phorton1/Arduino-boat-teensyGPS/docs/3dp/gps_test_nut1.3mf

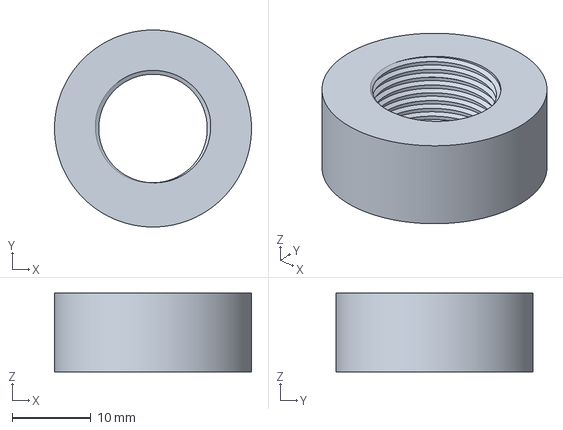
[picture p1: CAD file, 2026-04-03]
docs/3dp/gps_test_nut1.3mf
25.0 x 25.0 x 10.0 mm
