phorton1/Arduino-boat-teensyGPS/docs/3dp/gps_test_nut2.3mf

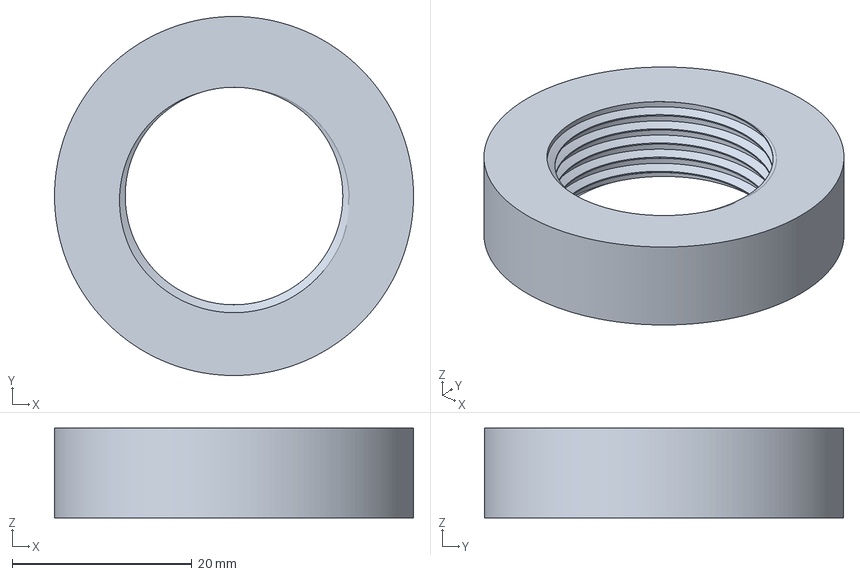
[picture p2: CAD file, 2026-04-03]
docs/3dp/gps_test_nut2.3mf
40.0 x 40.0 x 10.0 mm
