phorton1/Arduino-boat-teensyGPS/docs/3dp/gps_mount.3mf

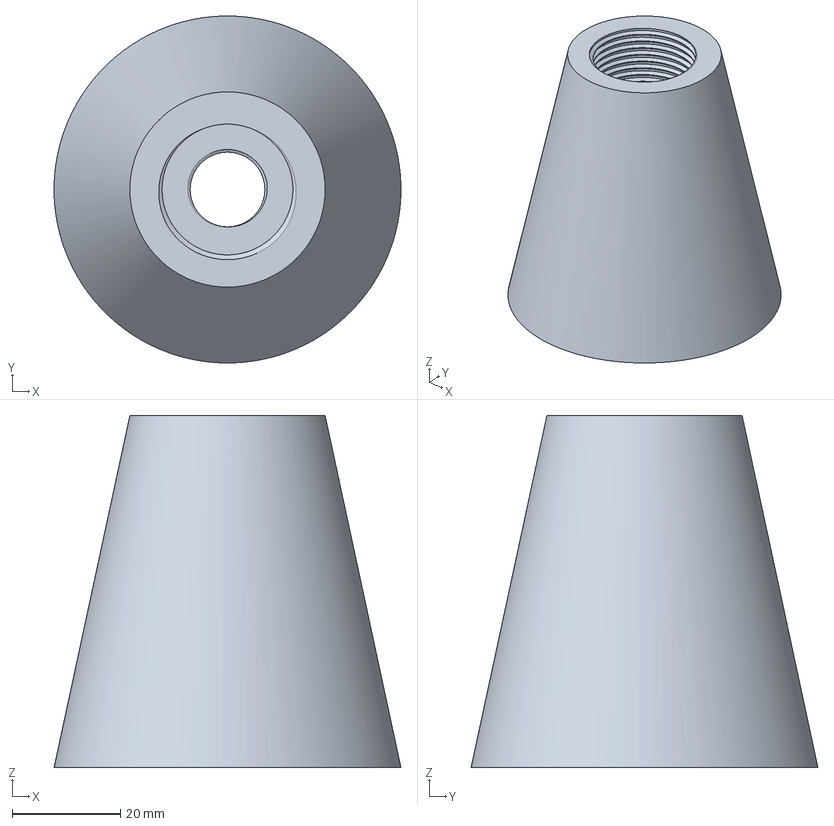
[picture p3: CAD file, 2026-04-03]
docs/3dp/gps_mount.3mf
64.0 x 64.0 x 65.0 mm
