phorton1/Arduino-boat-teensyGPS/docs/3dp/neo_support.3mf

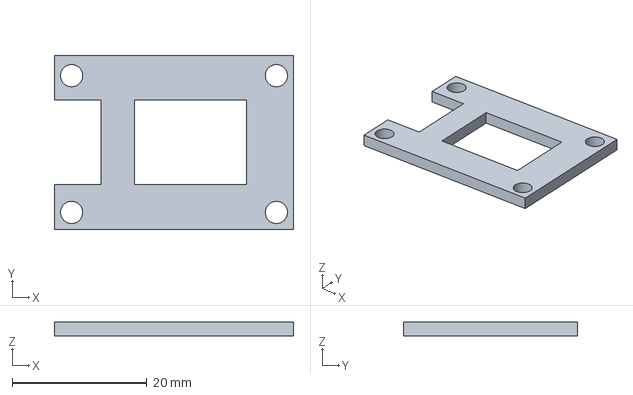
[picture p4: CAD file, 2026-02-25]
docs/3dp/neo_support.3mf
35.5 x 25.8 x 2.10 mm
