phorton1/Arduino-boat-teensyGPS/docs/3dp/gps_case.3mf

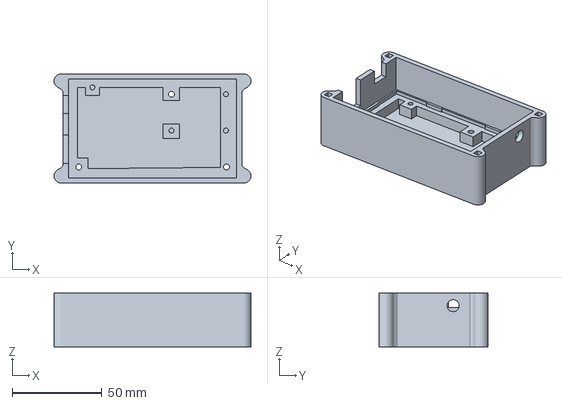
[picture p5: CAD file, 2026-02-25]
docs/3dp/gps_case.3mf
110.0 x 61.0 x 30.0 mm
