phorton1/Arduino-boat-teensyGPS/docs/3dp/gps_top.3mf

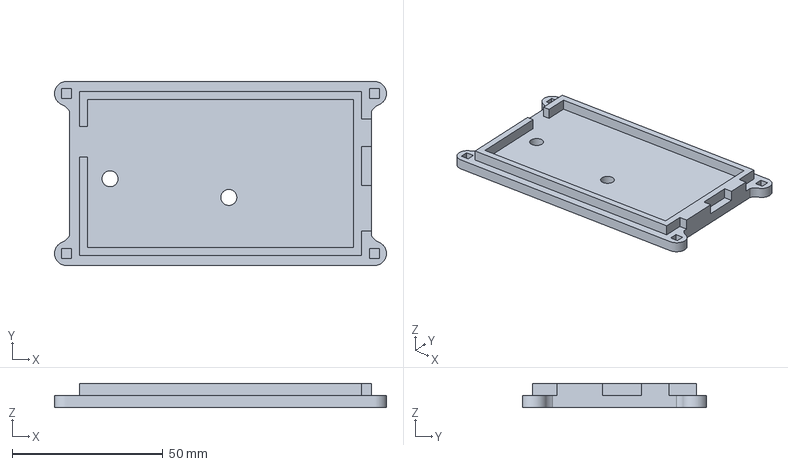
[picture p6: CAD file, 2026-02-25]
docs/3dp/gps_top.3mf
110.0 x 61.0 x 8.00 mm
