phorton1/Arduino-boat-teensyGPS/(list of files, cad)

Other CAD files:
docs/3dp/gps_box.f3d
docs/3dp/gps_case.stl
docs/3dp/gps_mount.stl
docs/3dp/gps_test_nut1.stl
docs/3dp/gps_test_nut2.stl
docs/3dp/gps_top.stl
docs/3dp/neo_support.stl
