phorton1/Arduino-boat-teensyGPS/docs/kicad/gps_board/gps_board.kicad_pcb

## KiCad design docs/kicad/gps_board/gps_board.kicad_pcb (2026-02-25)

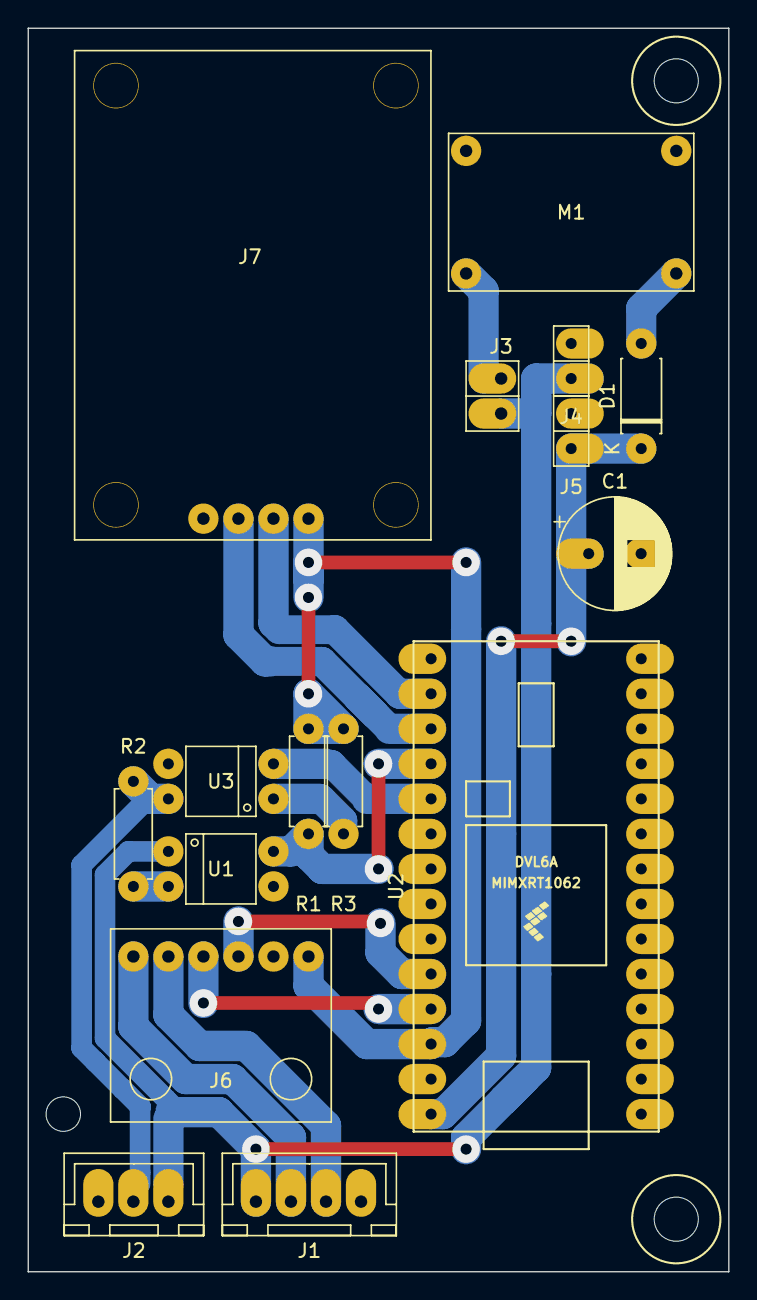
[picture p7: board gps_board.kicad_pcb from above]

Board: 2 copper layers, 50.8 x 90.2 mm, 16 parts (0 on the bottom side), 17 nets.

Parts:
C1: 100uf; CP_my100uf
D1: 1N5819; myDiodeSchotsky
J1: NMEA2000; JST4
J2: SEATALK; JST3
J3: BUCK_PWR; pinHeader1x2
J4: 12V_TEST; pinSocket1x2
J5: 5V_TEST; pinSocket1x2
J6: SN65HVD230; CANBUS_Module1
J7: NEO6M; neo6m
M1: BUCK01; myMini360BuckConverter
R1: 10K; myResistor
R2: 4.7K; myResistor
R3: 220; myResistor
U1, U3: TLP521; myDip4
U2: myTeensy4.0; teensy40

Connections:
+3V3: J6.1, J7.4, R1.1, R3.2, U2.26
+5V: C1.1, D1.1, J5.1, U2.28
+12V: J1.4, J2.1, J3.2, J4.1, U1.1
CANH: J1.2, J6.5
CANL: J1.3, J6.6
CRX: J6.3, U2.24
CTX: J6.4, U2.25
GND: C1.2, J1.1, J2.3, J4.2, J5.2, J6.2, J7.1, M1.1, M1.2, U1.3, U2.1, U2.27, U3.3
unnamed: D1.2, M1.3
unnamed: J3.1, M1.4
unnamed: R2.1, U1.2
unnamed: R3.1, U3.1
RX3: J7.2, U2.17
RX4: R1.2, U1.4, U2.18
ST1: J2.2, R2.2, U3.4
TX3: J7.3, U2.16
TX4: U2.19, U3.2
