phorton1/Arduino-boat-teensyGPS/(commit log)

2026-02-04 different DEV_QUERIY sub_versions for ST GPS devices; implemented response to Restart GPS button implementeed newly found ST_TARGET_NAME/ST_TARGET_ID parsing
2026-02-06 Sanity checkin before rework for "real" teensyGPS.ino breadboard & possible PCB
    [teensyGPS.ino]
2026-02-06 remove UI/implementation and move neoGPS to teensyGPS repo - cleanup NMEA2000 device (teensyBoat vs teensyGPS) initialization - update preferences.txt's to back two plugs on Lenovo3
2026-02-07 Be an NMEA2000 device even when not explicitly sending GPS PGN's
2026-02-20 new teensyGPS pcb gps_board
    [gps_board.kicad_pcb, gps_board.sch]
2026-02-20 rework teensyGPS incluging new pins, refactoring it and teensyBoat ST stuff, NMEA2000 init, and monitoring commands
    [neo2000.cpp, neoGPS.cpp, neoGPS.h, neoST.cpp, teensyGPS.ino]
2026-02-20 made seatalk and nmea2000 enabled into functions (i.e. runtime switches) only used for Output/Parsing; made E80 RestartGPS button reboot teensyGPS
    [neoGPS.cpp, neoGPS.h, neoST.cpp, teensyGPS.ino]
2026-02-23 redesigned teensyGPS board (removed jumpers; needs EEPROM) before rotating for flatcam
    [gps_board.kicad_pcb, gps_board.sch]
2026-02-24 did flatcam stuff and milled teensyGPS PCB
    [gps_board before_rotating.kicad_pcb, gps_board.kicad_pcb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]
2026-02-25 3d print case
    [gps_box.f3d, gps_case.3mf, gps_case.stl, gps_top.3mf, gps_top.stl, neo_support.3mf, neo_support.stl]
2026-02-25 show resistor values switch jst jumpers
    [gps_board.kicad_pcb, gps_board.sch]
2026-04-03 print teensyGPS antenna pod (gps mount)
    [gps_mount.3mf, gps_mount.stl, gps_test_nut1.3mf, gps_test_nut1.stl, gps_test_nut2.3mf, gps_test_nut2.stl]
2026-05-10 teensyBoat documentation pass
